ozerik/MushroomHat/BOM_Mushroom-Hat_2024-07-04.csv

ID | Name | Designator | Footprint | Quantity | Manufacturer Part | Manufacturer | Supplier | Supplier Part | Price
1 | 100nF | C14,C15 | C0603 | 2 | CC0603KRX7R9BB104 | YAGEO(国巨) | LCSC | C14663 | 0.002
2 | 4.7nF | C1,C2 | C0603 | 2 | 0603B472K500NT | FH(风华) | LCSC | C53987 | 0.003
3 | 15nF | C3,C4 | C0603 | 2 | 0603B153K500NT | FH(风华) | LCSC | C1596 | 0.004
4 | 150nF | C5,C6 | C0603 | 2 | 0603B154K500NT | FH(风华) | LCSC | C1597 | 0.015
5 | 1uF | C7,C8,C9,C12,C13 | C0603 | 5 | CL10A105KB8NNNC | SAMSUNG(三星) | LCSC | C15849 | 0.005
6 | B5819W_C8598 | D1,D2,D3 | SOD-123_L2.7-W1.6-LS3.7-RD-1 | 3 | B5819W | CJ | LCSC | C8598 | 0.026
7 | Arduino_Nano_Header | J1 | ARDUINO NANO JUANITO | 1
8 | Mic module | J2 | HDR-M-2.54_1X3 | 1 |  |  | LCSC | C180248 | 0.181
9 | LED strip | J5 | HDR-M-2.54_1X3 | 1 |  |  | LCSC | C180248 | 0.181
10 | Battery In | J3 | HDR-M-2.54_1X2 | 1 |  |  | LCSC | C124375 | 0.023
11 | trigger | J4 | TH_ONKICONN_SMALL_LED | 1
12 | 10kΩ | R2 | R0603 | 1 | 0603WAF1002T5E | UNI-ROYAL(厚声) | LCSC | C25804 | 0.001
13 | 1kΩ | R6,R7,R8,R18,R19,R20,R21 | R0603 | 7 | 0603WAF1001T5E | UNI-ROYAL(厚声) | LCSC | C21190 | 0.001
14 | 470kΩ | R9,R10,R11 | R0603 | 3 | 0603WAF4703T5E | UNI-ROYAL(厚声) | LCSC | C23178 | 0.001
15 | 470Ω | R12,R13,R14 | R0603 | 3 | 0603WAF4700T5E | UNI-ROYAL(厚声) | LCSC | C23179 | 0.001
16 | 100kΩ | R15,R16,R17 | R0603 | 3 | 0603WAF1003T5E | UNI-ROYAL(厚声) | LCSC | C25803 | 0.001
17 | bass 100K | R3 | POT BETTER | 1 | RK09D1130C4G | ALPSALPINE(阿尔卑斯阿尔派) | LCSC | C2687325
18 | mid 100K | R4 | POT BETTER | 1 | RK09D1130C4G | ALPSALPINE(阿尔卑斯阿尔派) | LCSC | C2687325
19 | treb 100K | R5 | POT BETTER | 1 | RK09D1130C4G | ALPSALPINE(阿尔卑斯阿尔派) | LCSC | C2687325
20 | Bipolar power module | U2 | BIPOLAR POWER MODULE | 1
21 | BrightLED 1 and 2 | U4 | 1X4_2.54MM_MALE_PIN_HEADER | 1
22 | Bright LED 3 and 4 | U5 | 1X4_2.54MM_MALE_PIN_HEADER | 1
23 | LM324DT | U1 | SOIC-14_L8.7-W3.9-P1.27-LS6.0-BL | 1 | LM324DT | ST(意法半导体) | LCSC | C71035 | 0.109
24 | PowerOut | J6 | HDR-M-2.54_1X2 | 1 |  |  | LCSC | C124375 | 0.023
25 | Power Switch | SW1 | SMTS-TOGGLE-SWITCH-JUANITO | 1 | 100SP1T1B1M2QEH | E-Switch | LCSC | C273351 | 3.408
