ozerik/MushroomHat/Schematic_Mushroom-Hat_2024-07-04.pdf

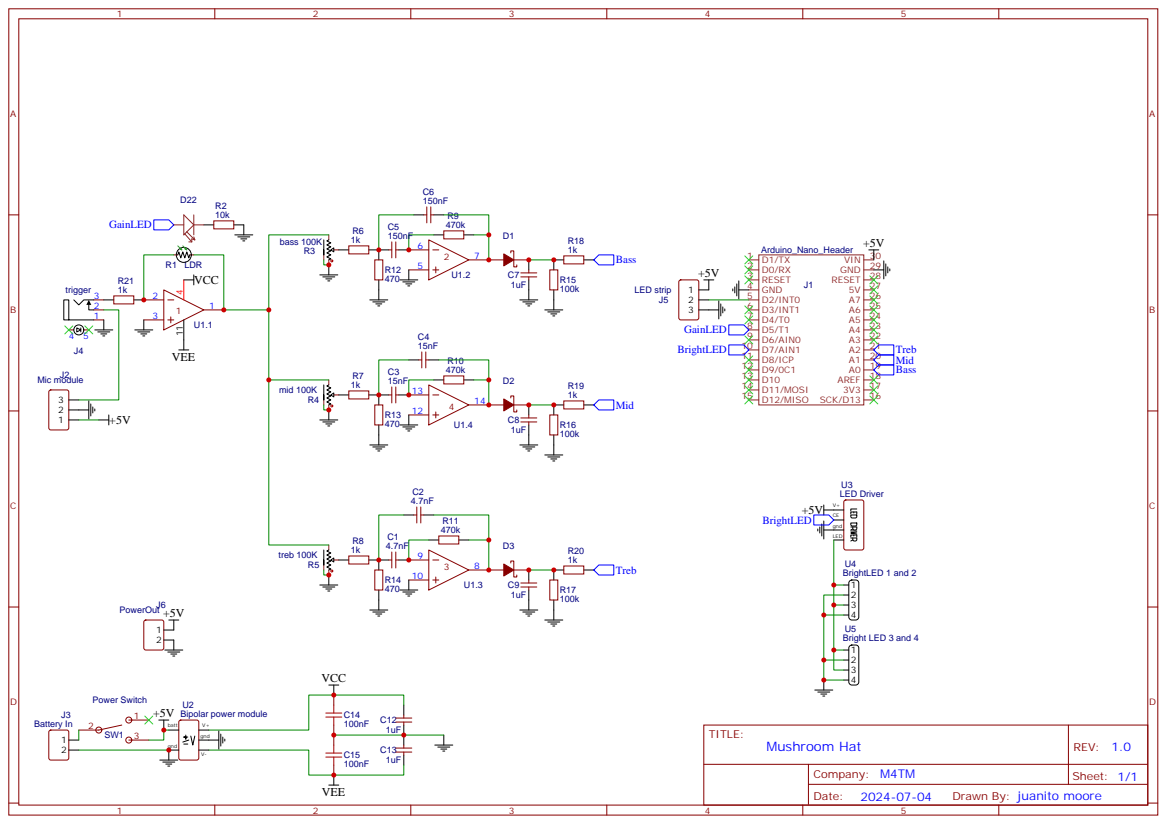
[picture p1: page 1]

Drawn By: juanito moore
